samuk/OpenDualMotorDriver/Hardware/PCB-Renders/1_TopLayer.PNG

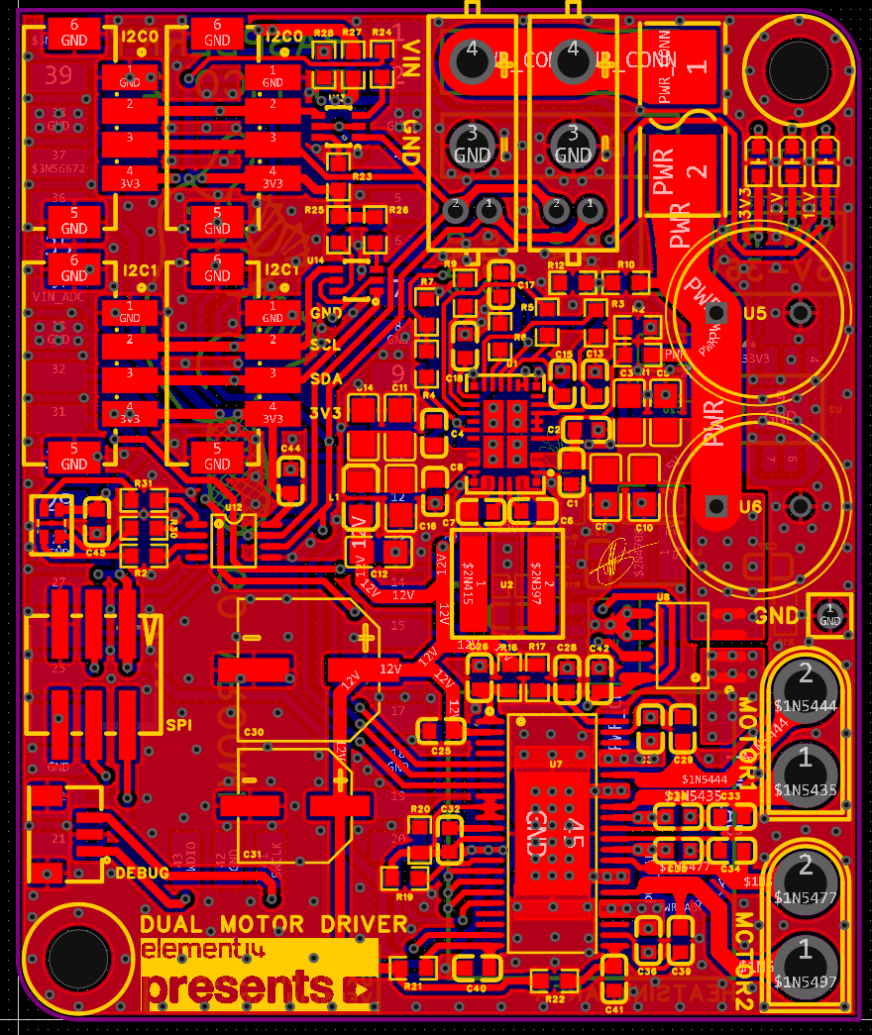
Hardware/PCB-Renders/1_TopLayer.PNG
