samuk/OpenDualMotorDriver/Hardware/PCB-Renders/2_GNDLayer1.PNG

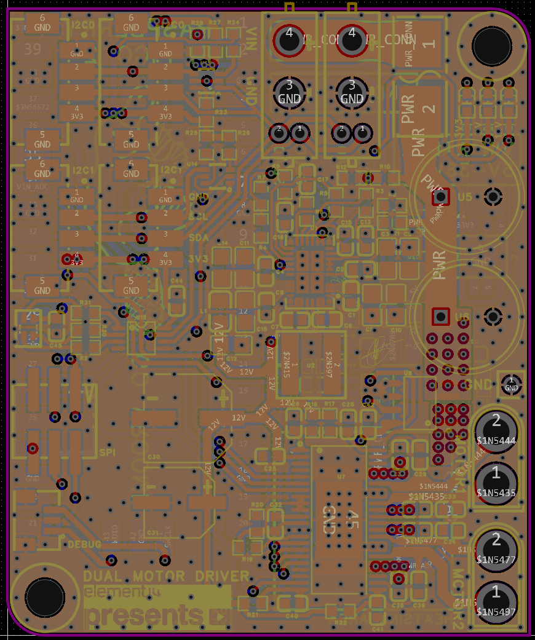
Hardware/PCB-Renders/2_GNDLayer1.PNG
