samuk/OpenDualMotorDriver/Hardware/PCB-Renders/3_GNDLayer2.PNG

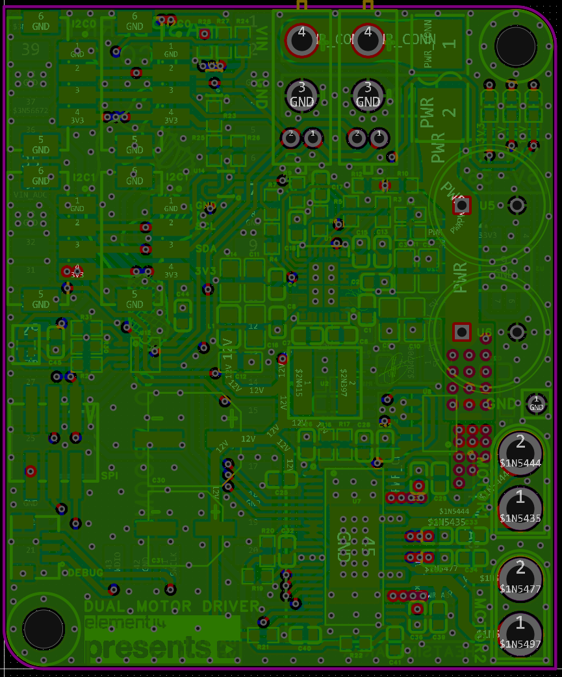
Hardware/PCB-Renders/3_GNDLayer2.PNG
