samuk/OpenDualMotorDriver/Hardware/PCB-Renders/4_BottomLayer.PNG

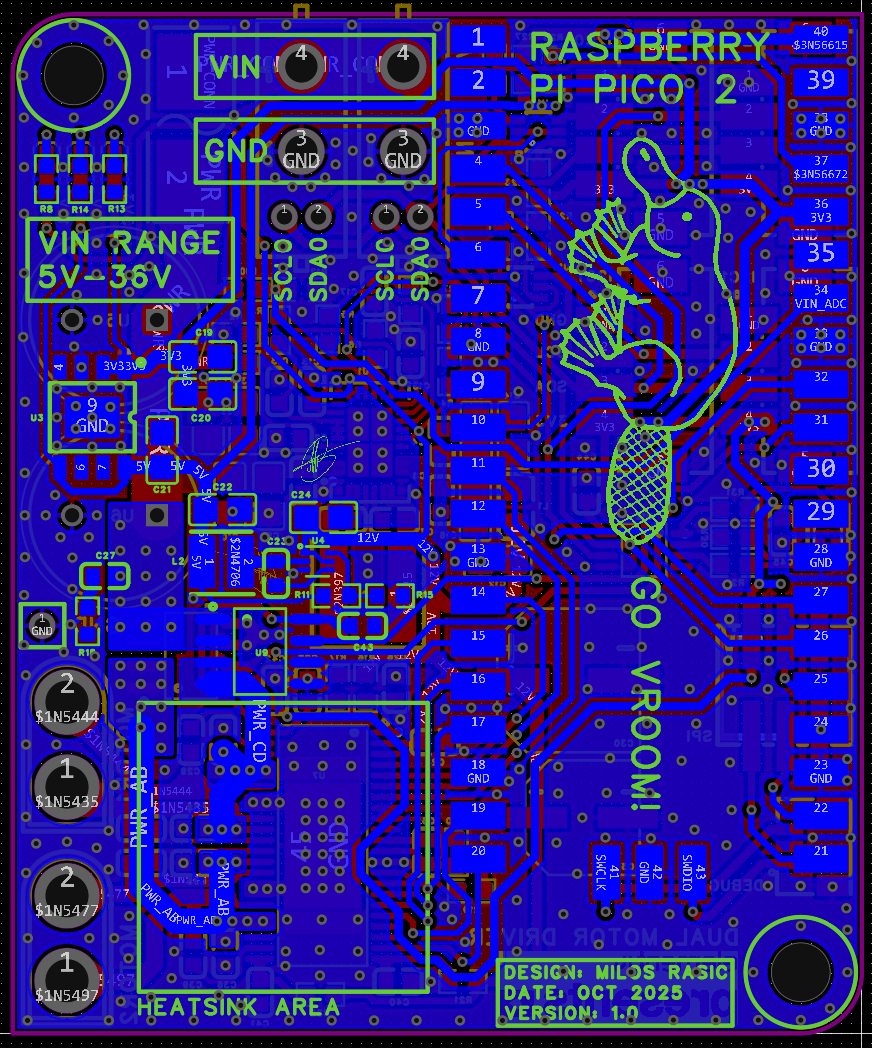
Hardware/PCB-Renders/4_BottomLayer.PNG
