samuk/OpenDualMotorDriver/Hardware/PCB-Renders/PCB_3D_2.PNG

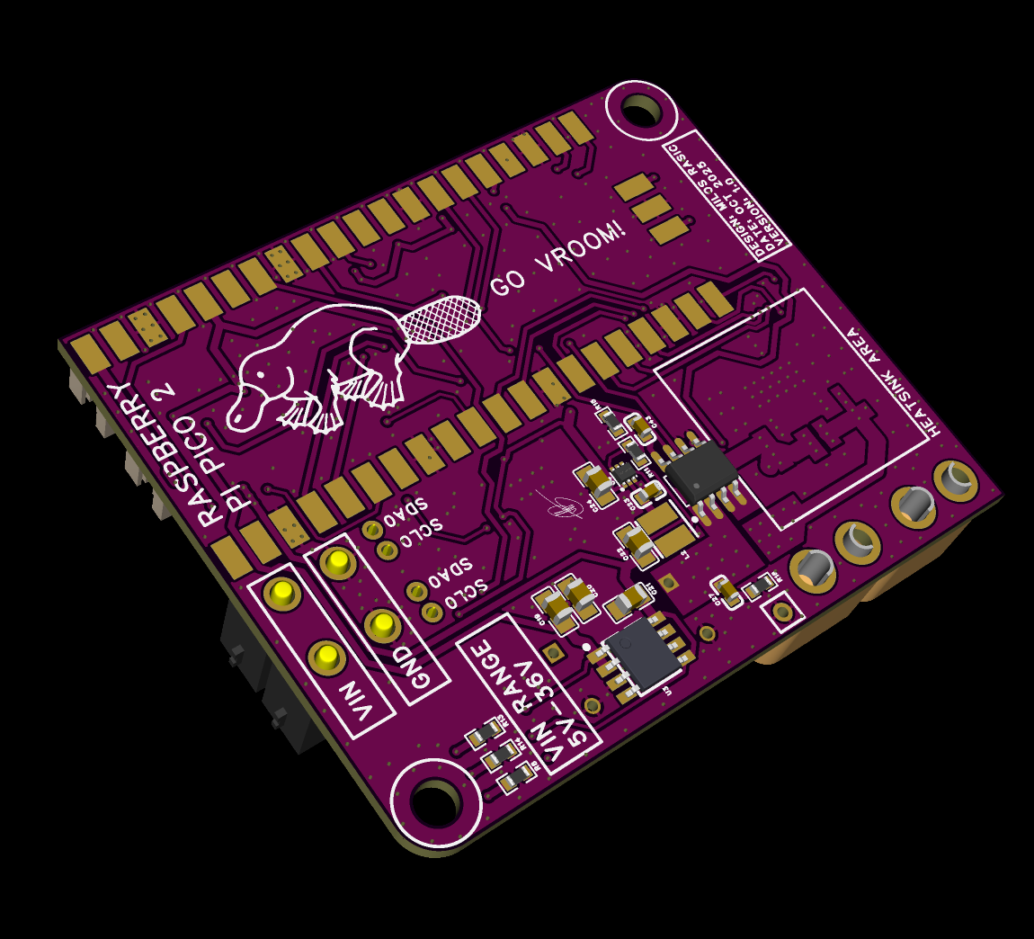
Hardware/PCB-Renders/PCB_3D_2.PNG
