samuk/OpenDualMotorDriver/Hardware/PCB-Renders/PCB_bottom.PNG

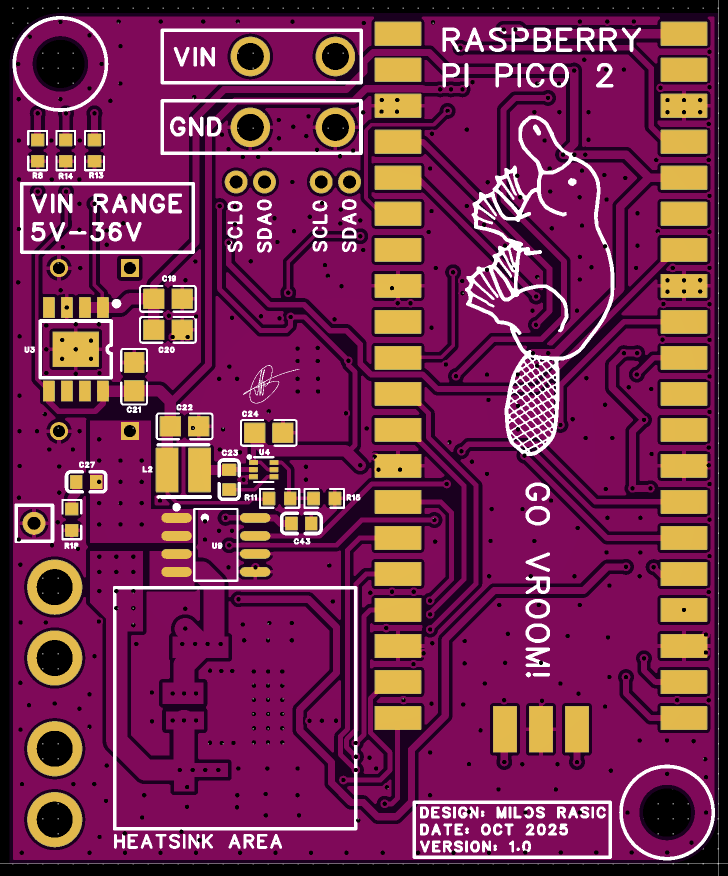
Hardware/PCB-Renders/PCB_bottom.PNG
