samuk/OpenDualMotorDriver/Hardware/PCB-Renders/PCB_top.PNG

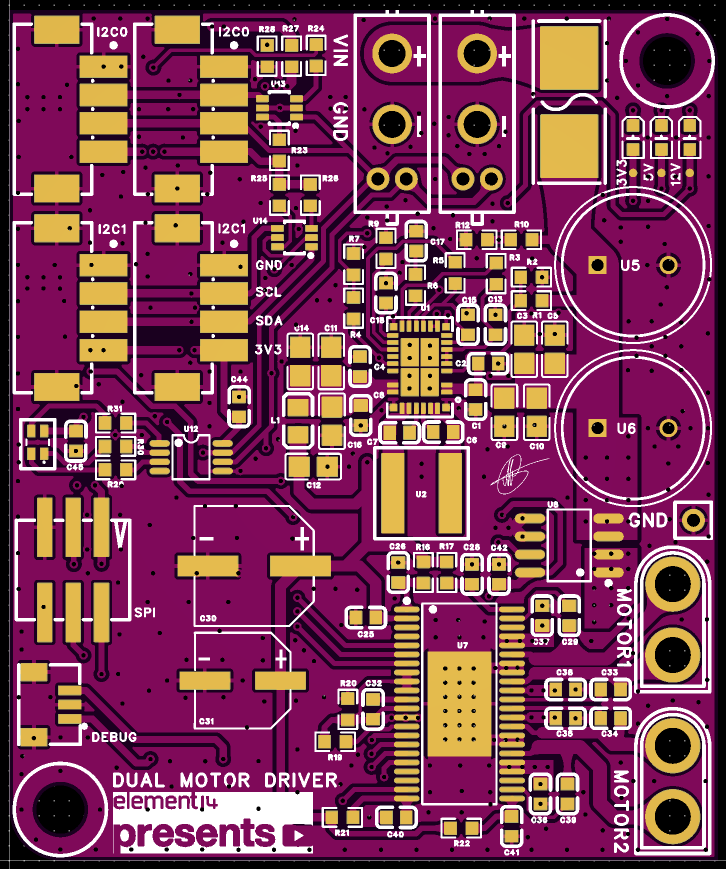
Hardware/PCB-Renders/PCB_top.PNG
