samuk/OpenDualMotorDriver/Images/DC696179-ED7C-47A8-8705-45DACD4E3CAB.JPG

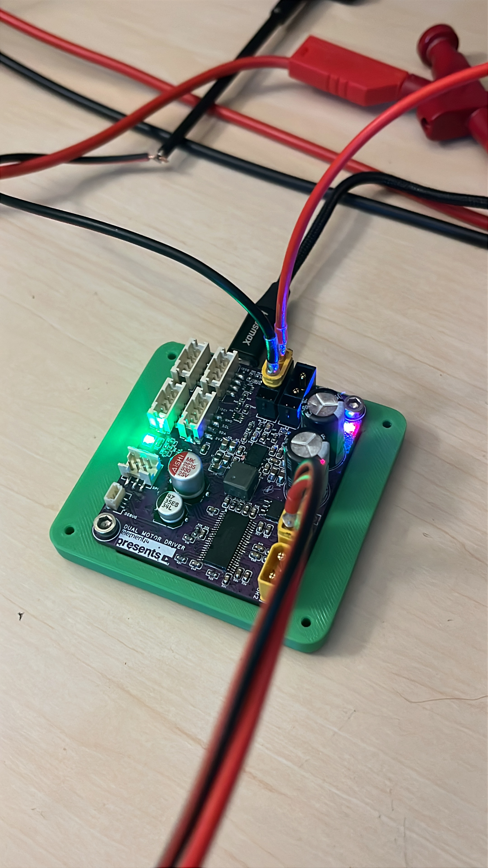
Images/DC696179-ED7C-47A8-8705-45DACD4E3CAB.JPG
