samuk/OpenDualMotorDriver/Images/Drawing3_PID.PNG

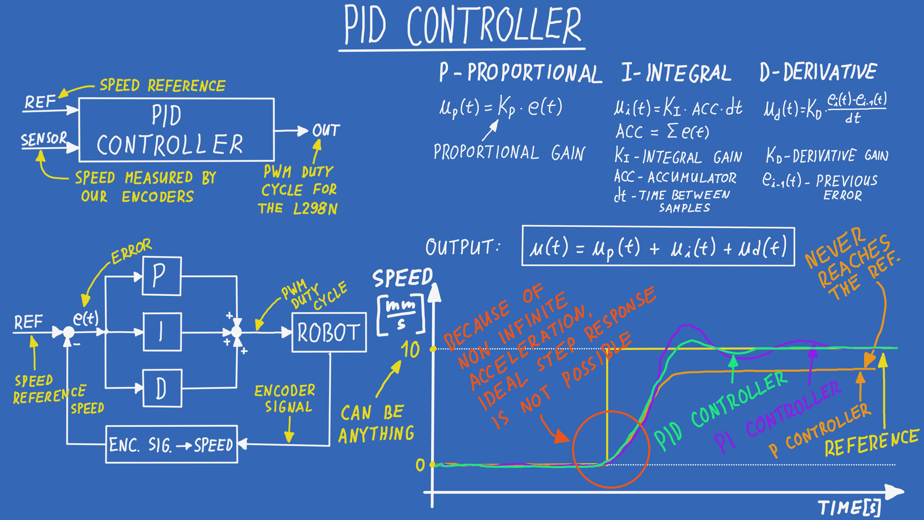
Images/Drawing3_PID.PNG
