samuk/OpenDualMotorDriver/Images/Drawing 1.PNG

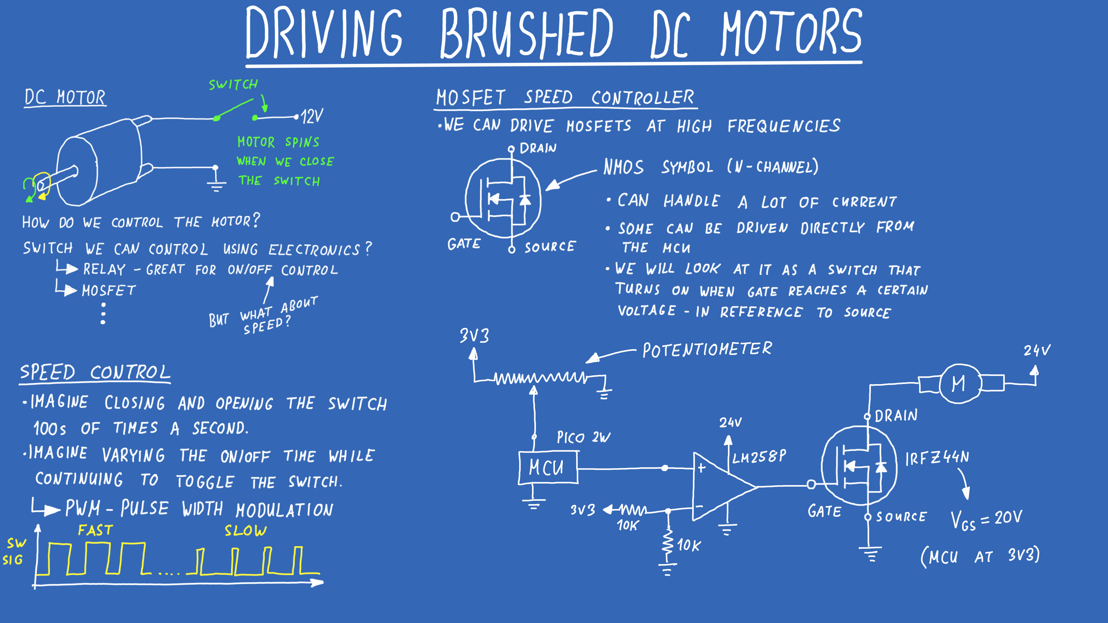
Images/Drawing 1.PNG
