samuk/OpenDualMotorDriver/Images/Drawing 2.PNG

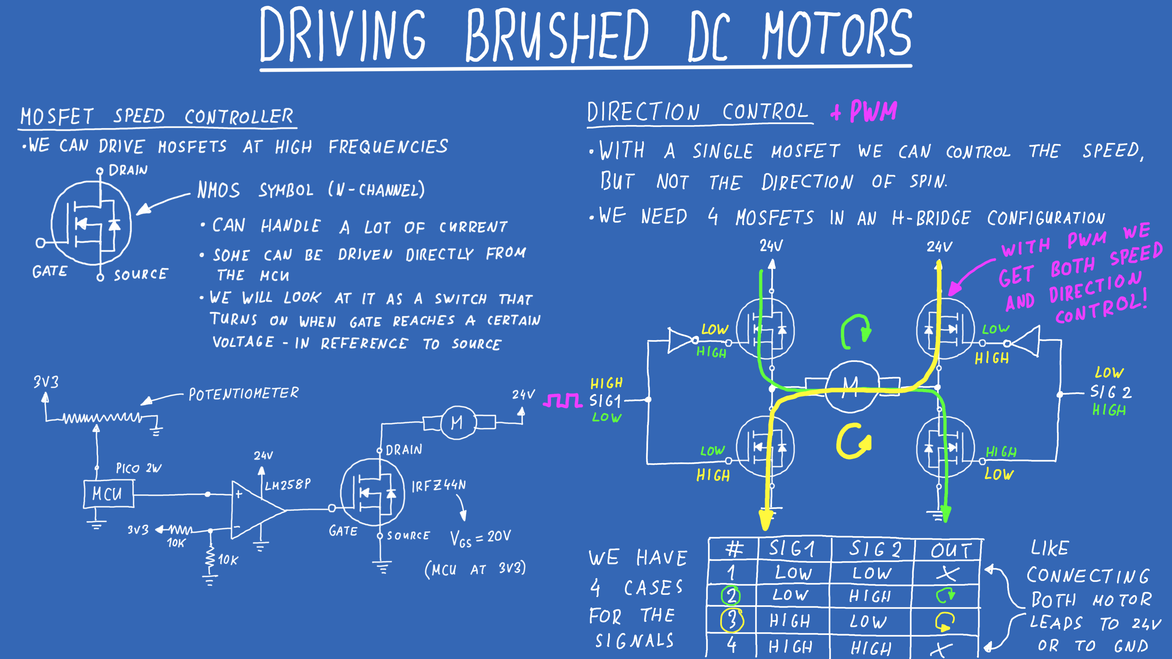
Images/Drawing 2.PNG
