samuk/OpenDualMotorDriver/Images/IMG_2347.JPG

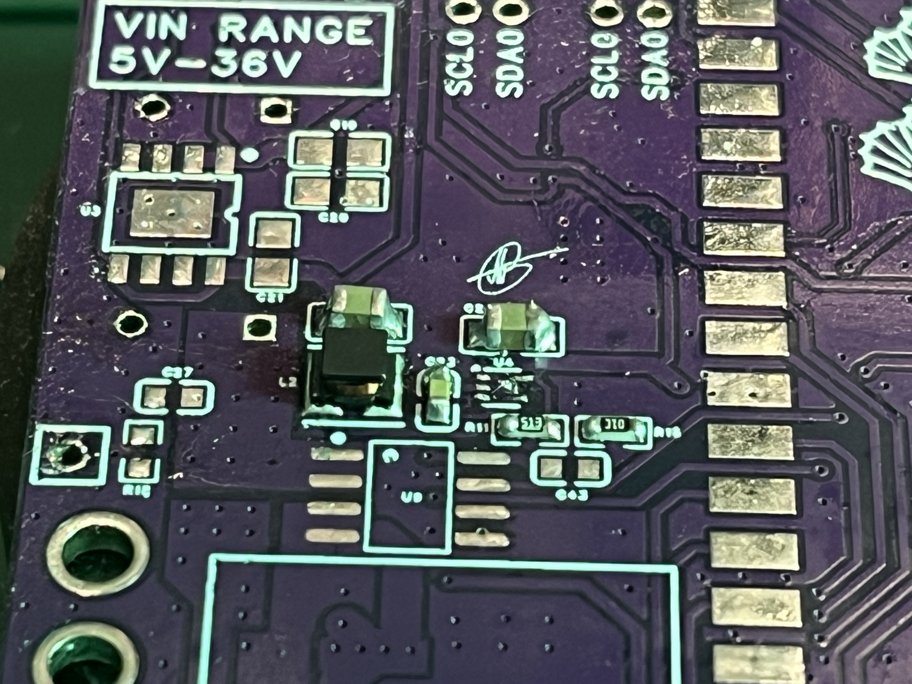
Images/IMG_2347.JPG
