samuk/OpenDualMotorDriver/Images/IMG_2360.JPG

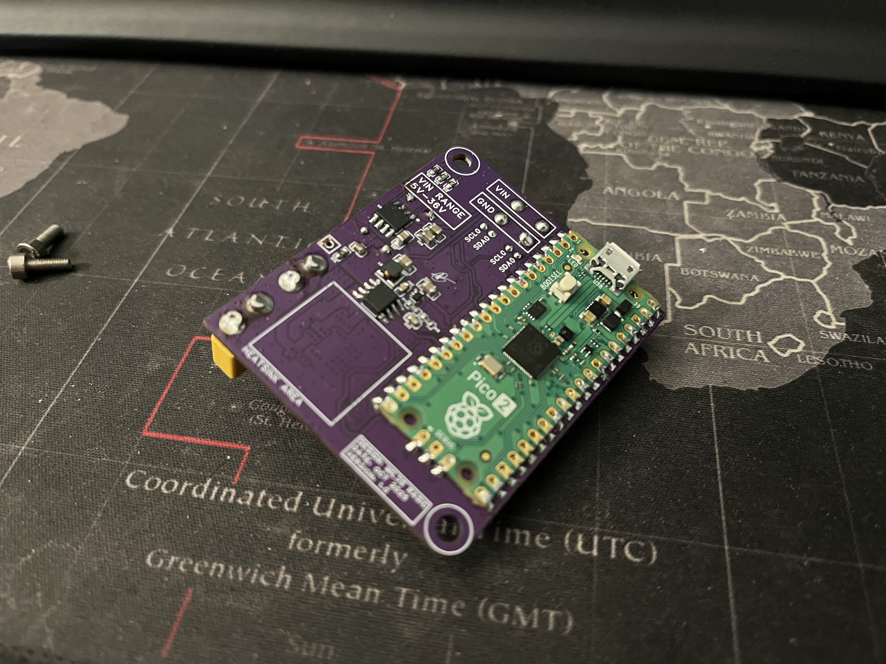
Images/IMG_2360.JPG
