samuk/OpenDualMotorDriver/Images/IMG_2361.JPG

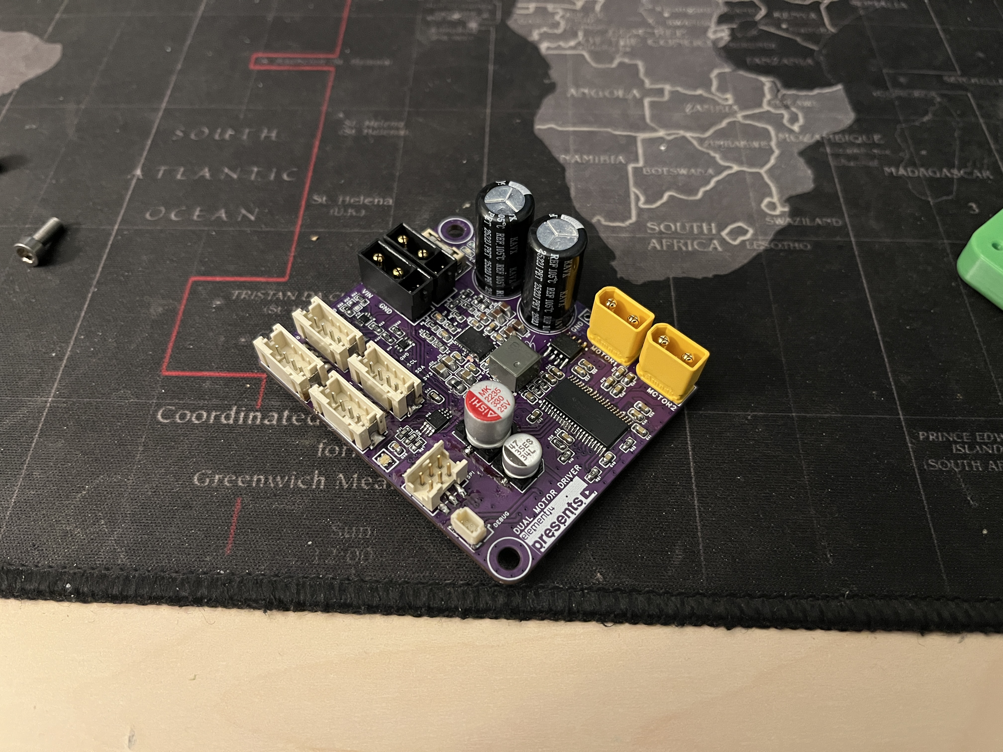
Images/IMG_2361.JPG
