samuk/OpenDualMotorDriver/Images/IMG_2495.JPG

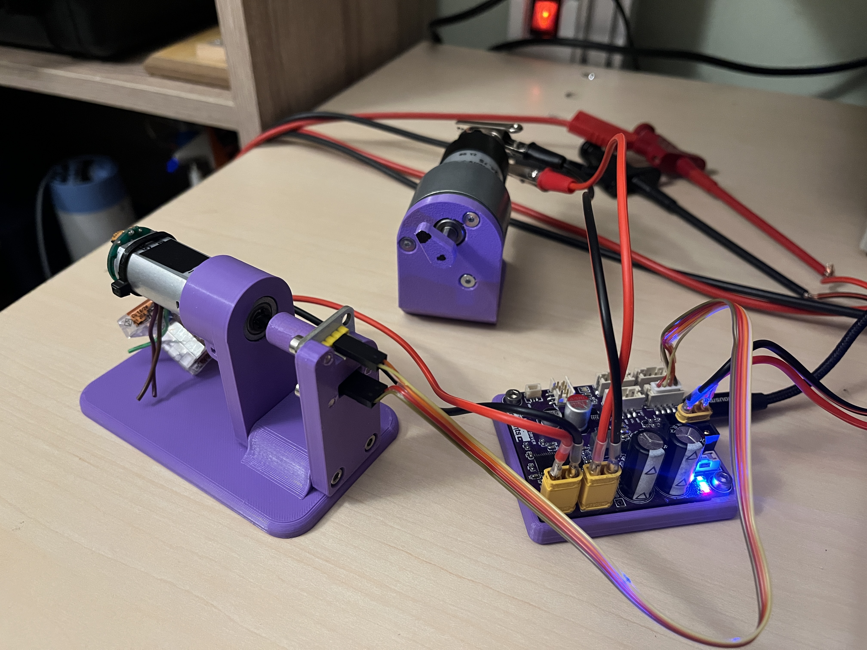
Images/IMG_2495.JPG
