samuk/OpenDualMotorDriver/Images/IMG_2496.JPG

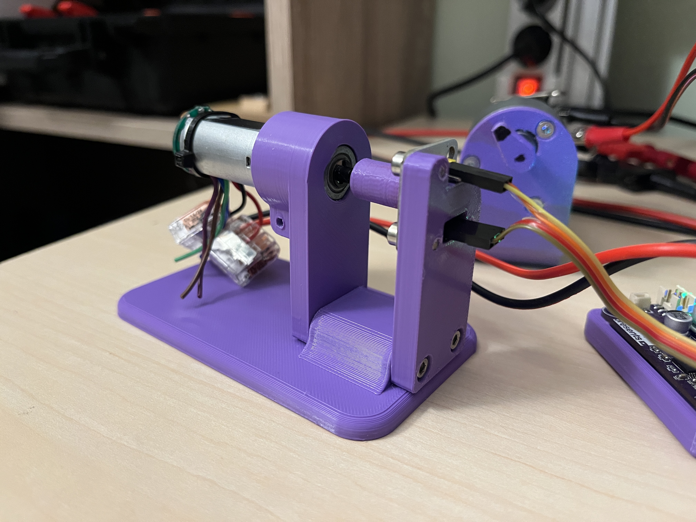
Images/IMG_2496.JPG
