samuk/OpenDualMotorDriver/Images/IMG_2497.JPG

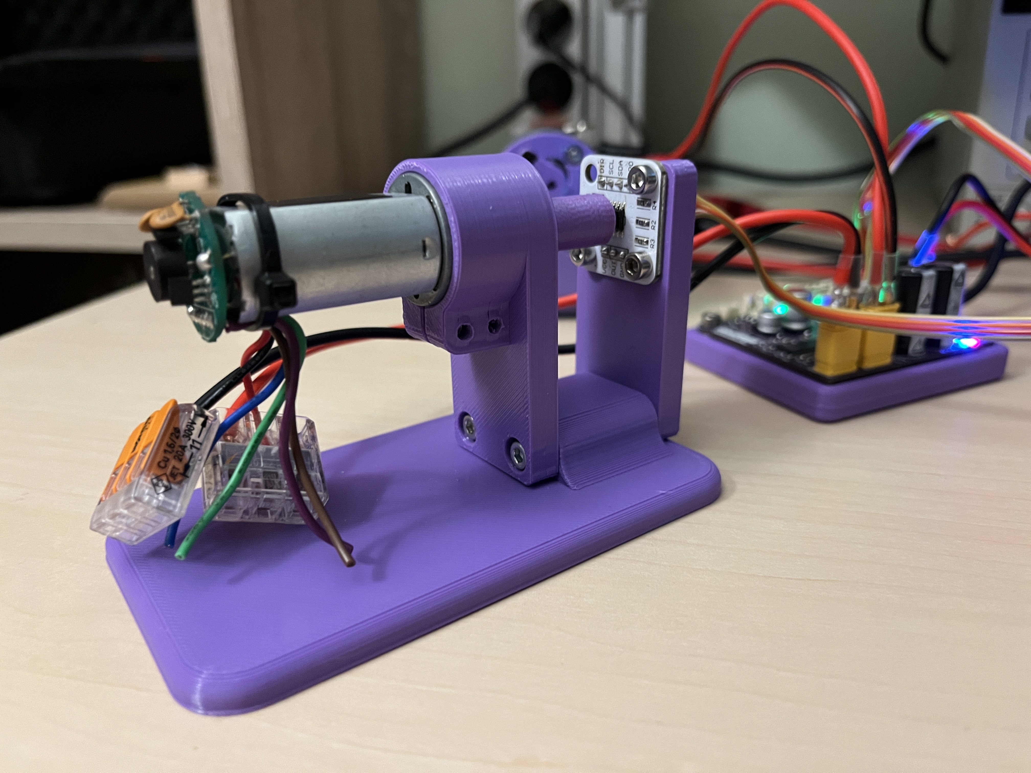
Images/IMG_2497.JPG
