samuk/OpenDualMotorDriver/Images/IMG_2498.JPG

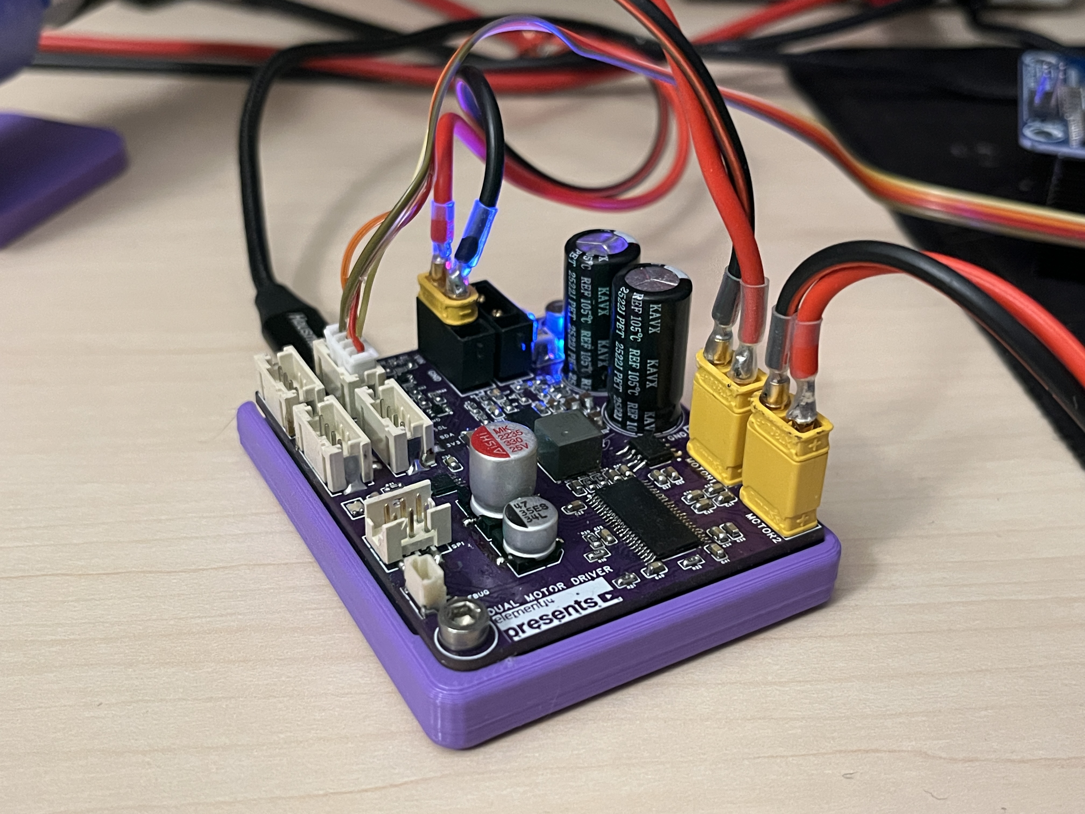
Images/IMG_2498.JPG
