samuk/OpenDualMotorDriver/Images/IMG_2499.JPG

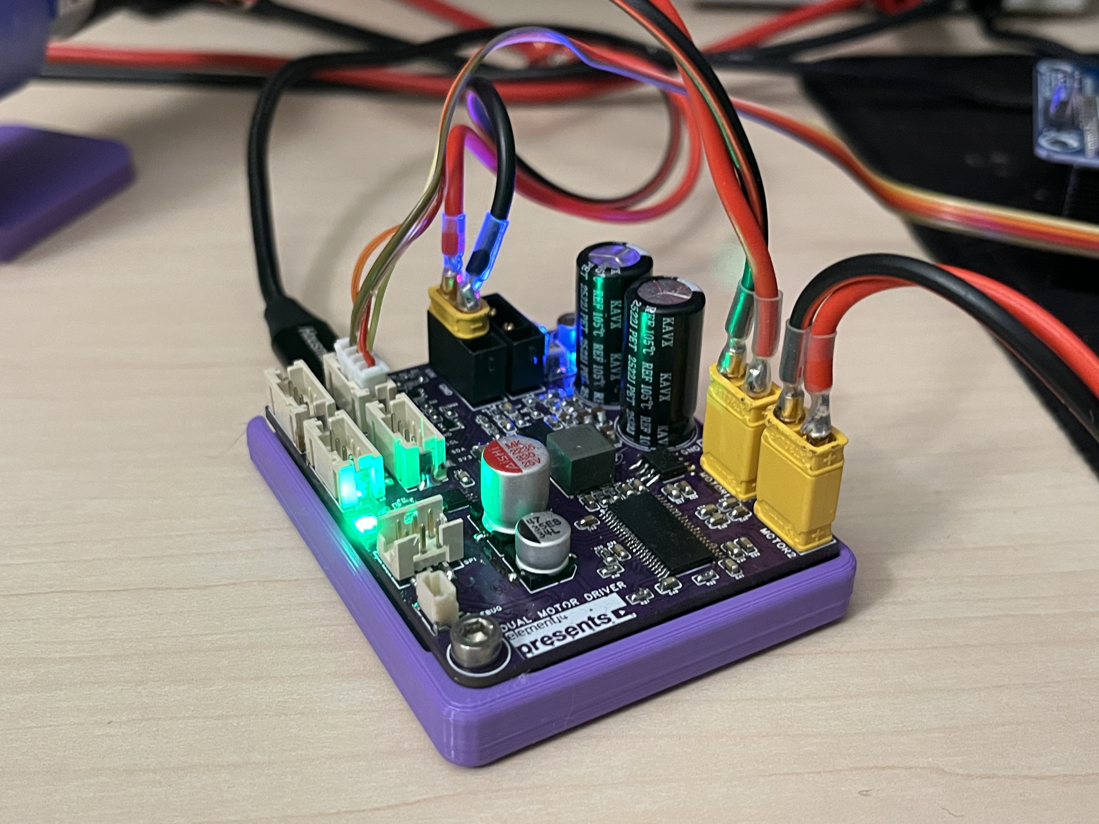
Images/IMG_2499.JPG
