samuk/OpenDualMotorDriver/Images/IMG_2500.JPG

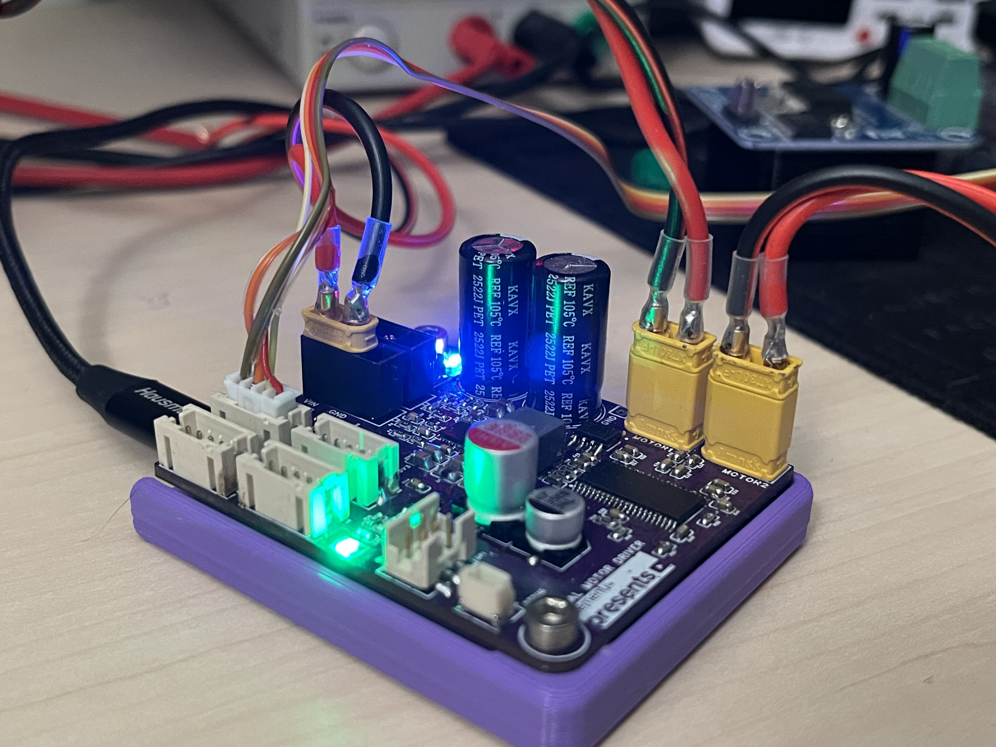
Images/IMG_2500.JPG
