samuk/OpenDualMotorDriver/Images/IMG_2501.JPG

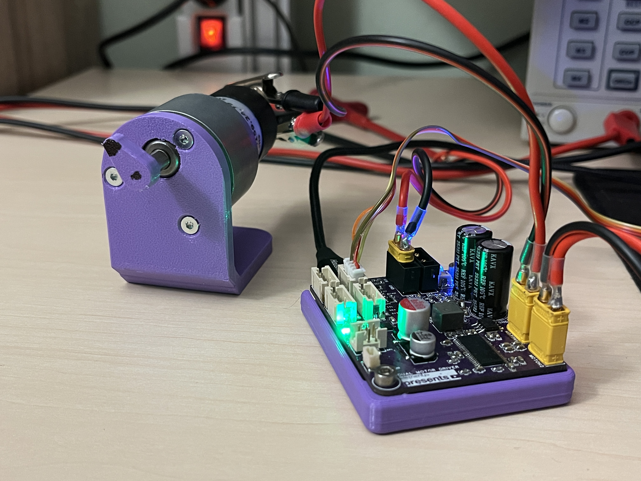
Images/IMG_2501.JPG
