samuk/OpenDualMotorDriver/Images/IMG_2502.JPG

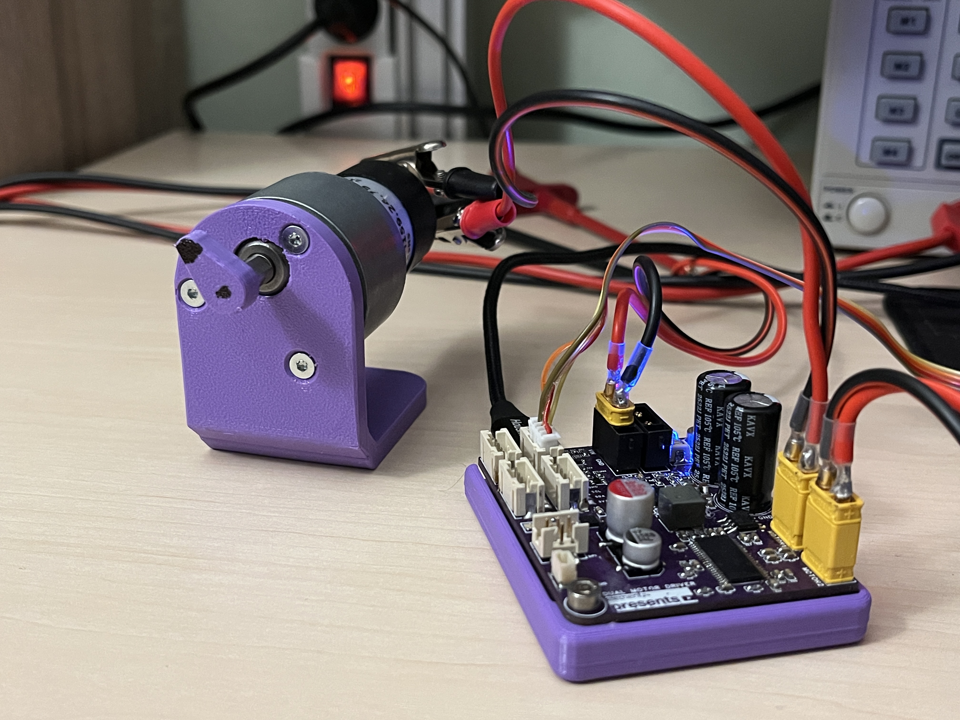
Images/IMG_2502.JPG
