samuk/OpenDualMotorDriver/Images/IMG_2504.JPG

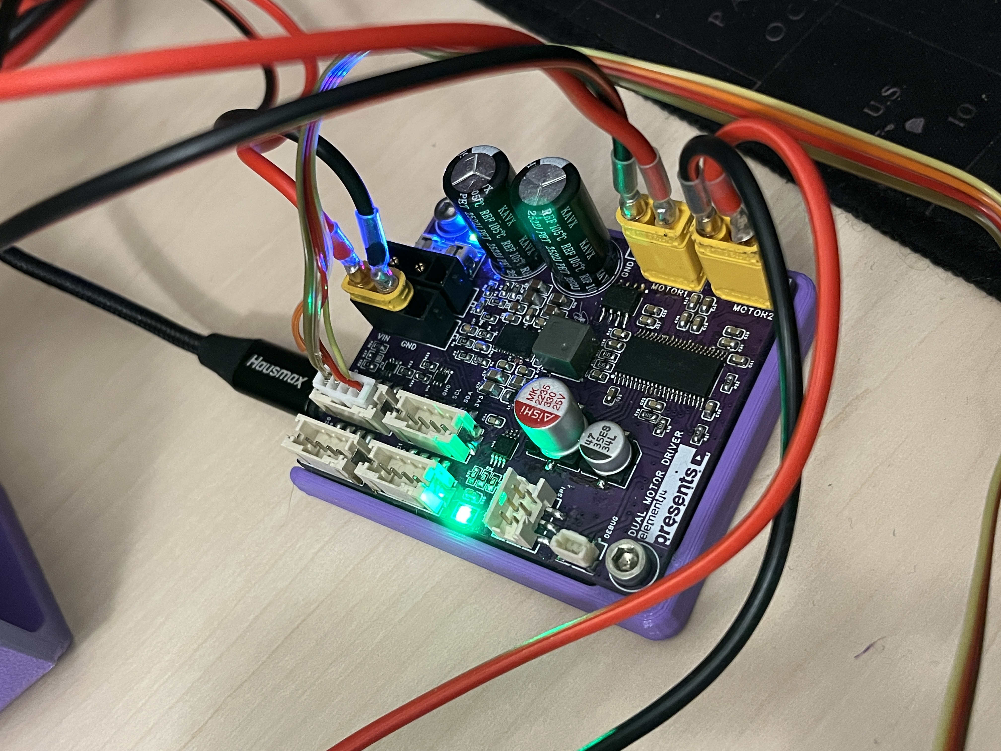
Images/IMG_2504.JPG
