samuk/OpenDualMotorDriver/Images/IMG_2505.JPG

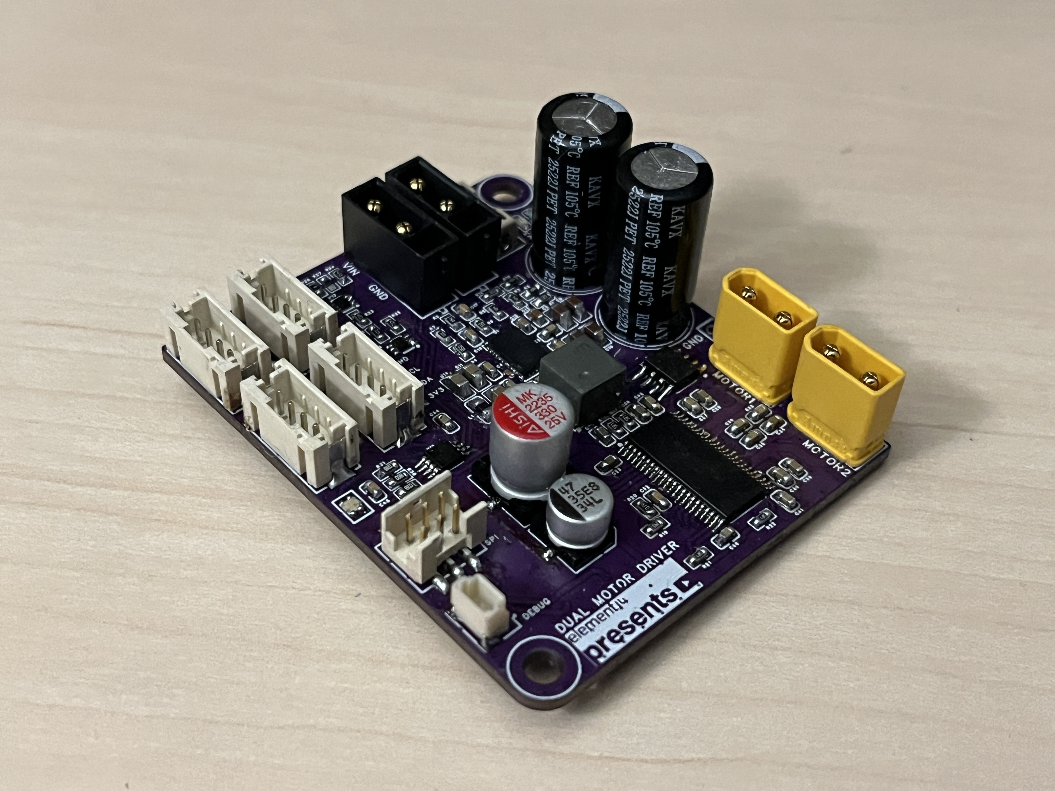
Images/IMG_2505.JPG
