samuk/OpenDualMotorDriver/Images/IMG_2508.jpg

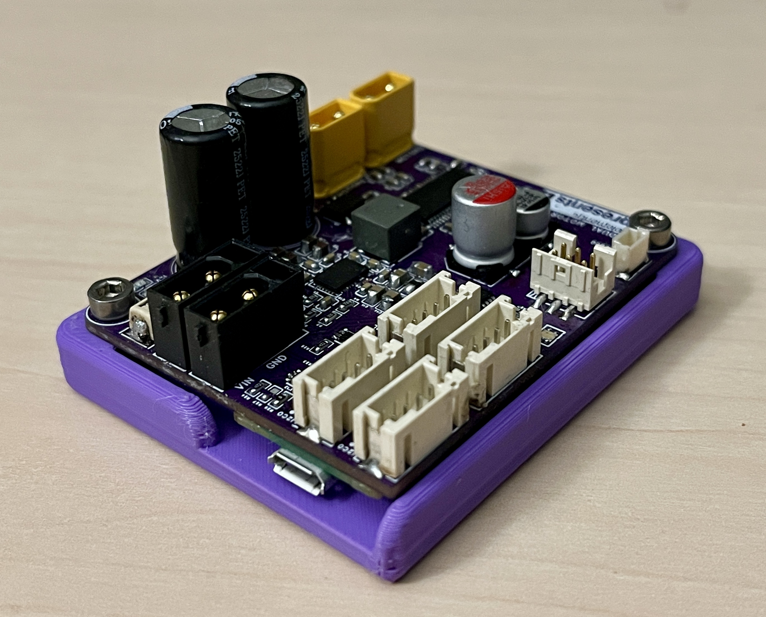
Images/IMG_2508.jpg
