samuk/OpenDualMotorDriver/Images/IMG_2509.jpg

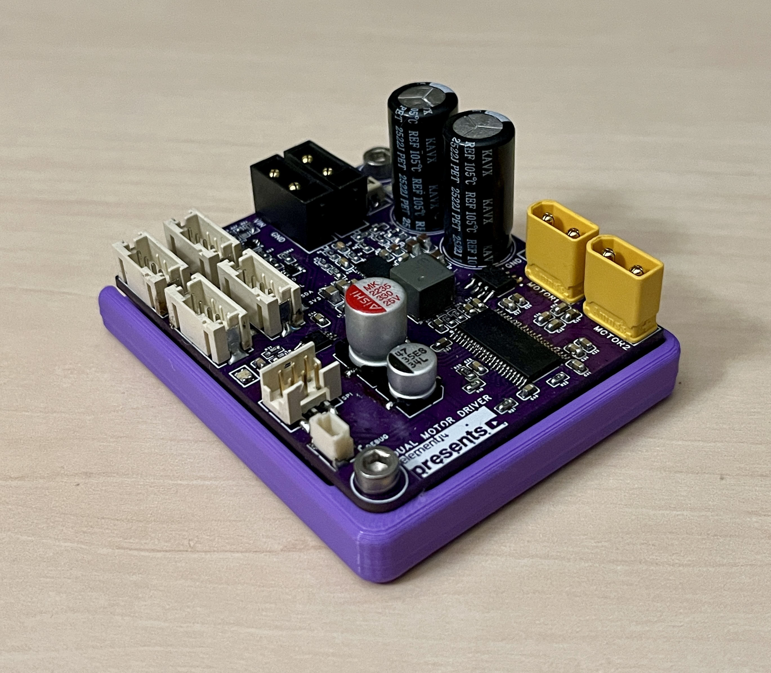
Images/IMG_2509.jpg
