samuk/OpenDualMotorDriver/Hardware/Schematics/SCH_Schematic1_2026-05-02.pdf

# BUCK BOOST CONVERTER 5-36V IN 12V 3A OUT

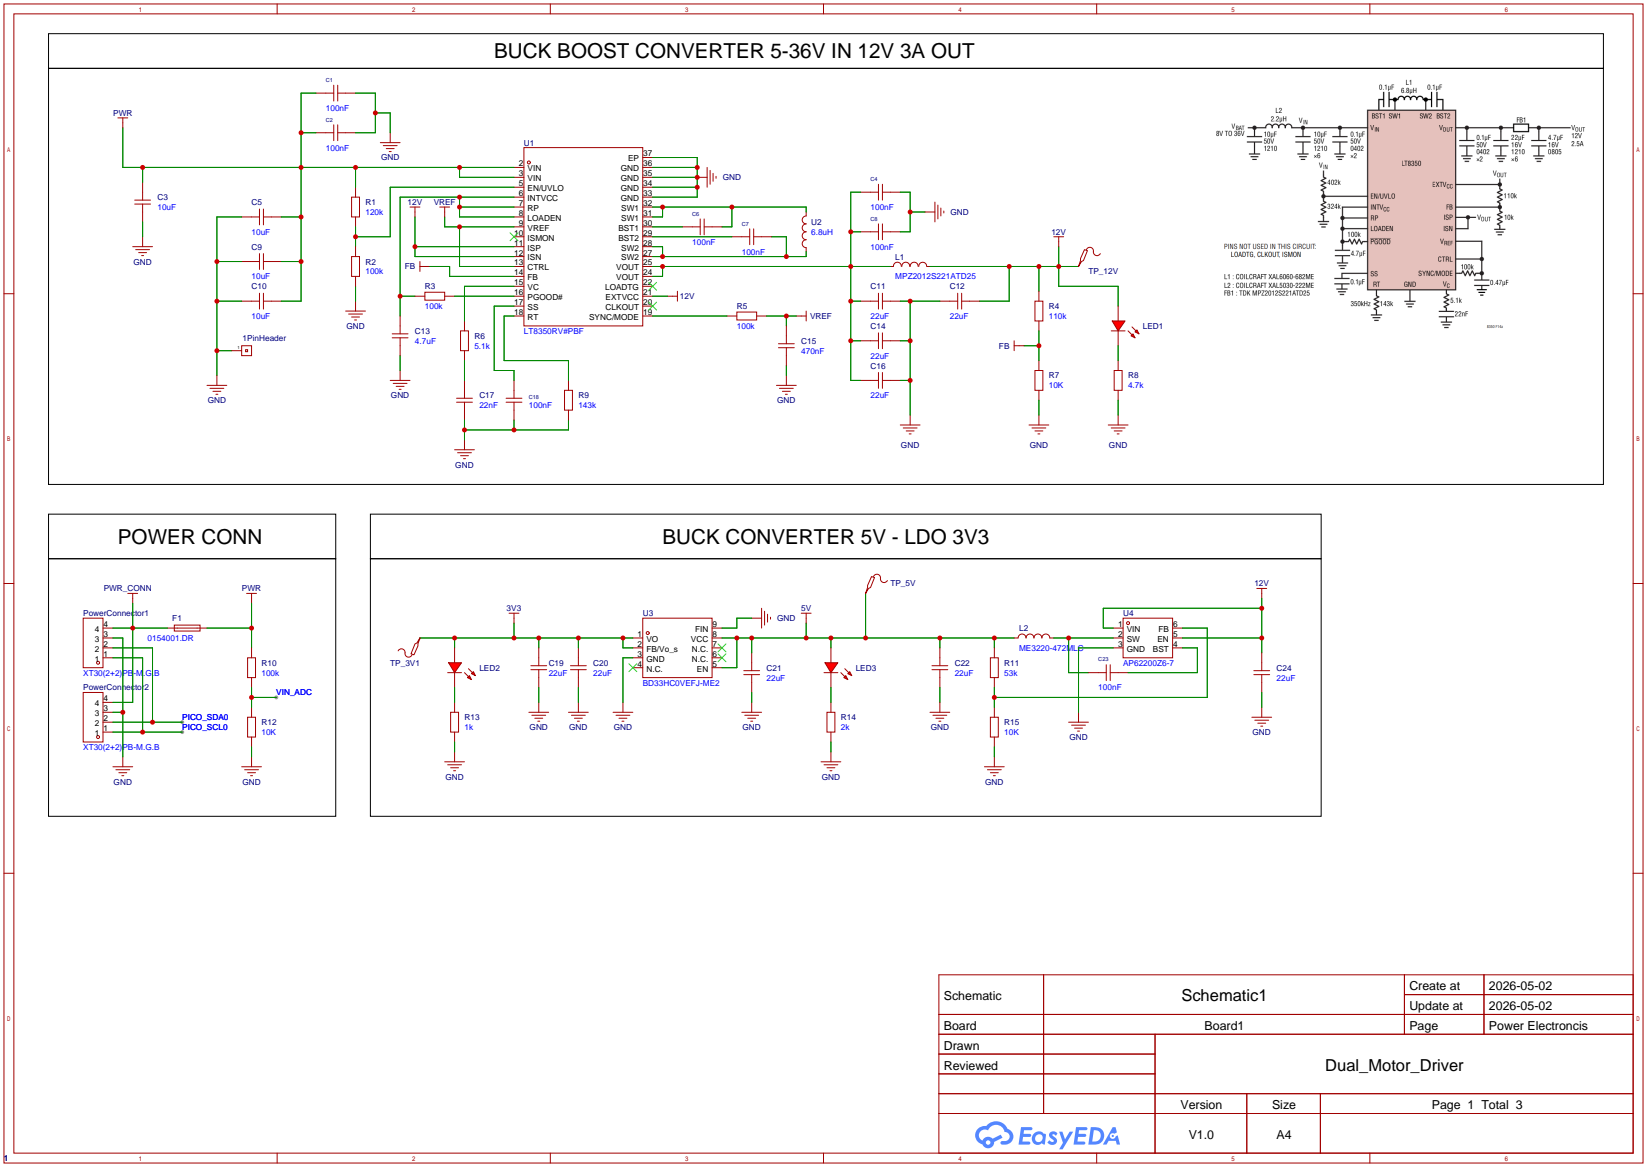
[picture p36: page 1]

Schematic | Schematic1 | Create at | 2026-05-02

Update at | 2026-05-02

Board | Board1 | Page | Power Electroncis
Drawn | | Dual_Motor_Driver
Reviewed

Version | Size | Page 1 Total 3
V1.0 | A4

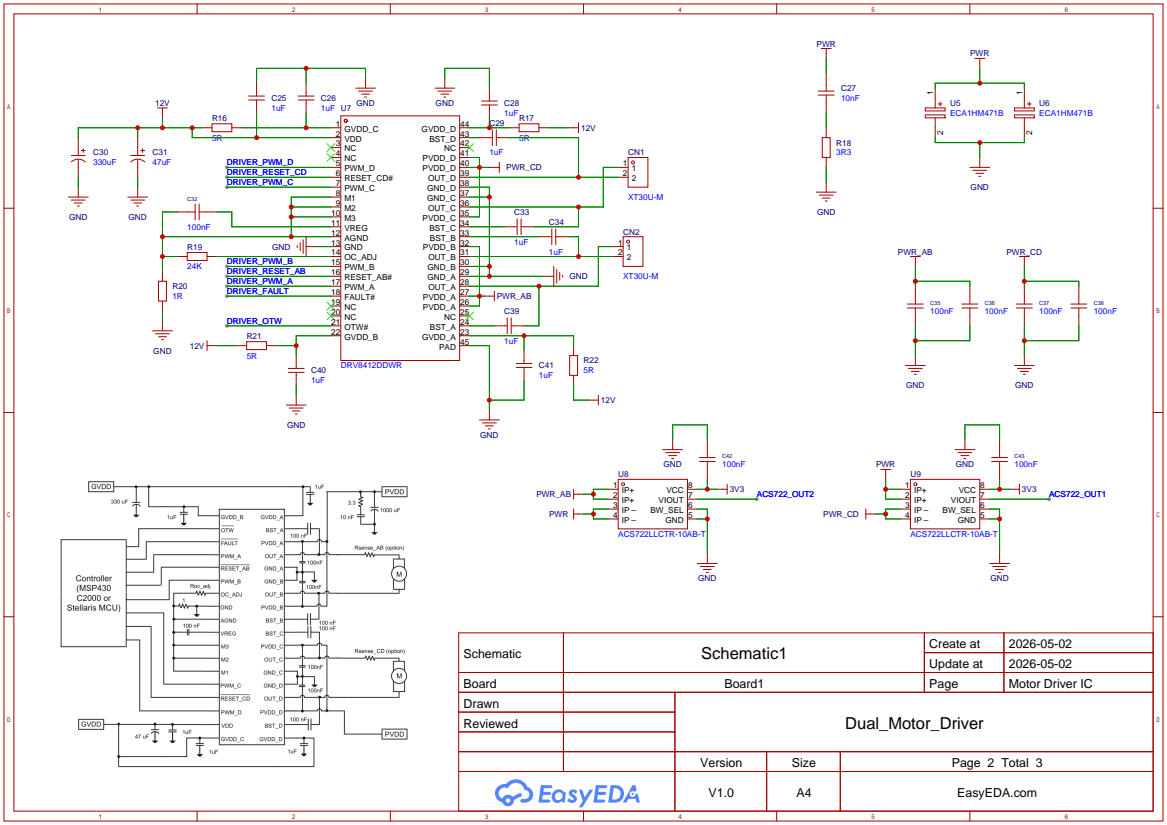
[picture p37: page 2]

Schematic | Schematic1 | Create at | 2026-05-02

Update at | 2026-05-02

Board | Board1 | Page | Motor Driver IC
Drawn | | Dual_Motor_Driver
Reviewed

Version | Size | Page 2 Total 3
V1.0 | A4 | EasyEDA.com

# I2C Connectors and Pull Up Circuit

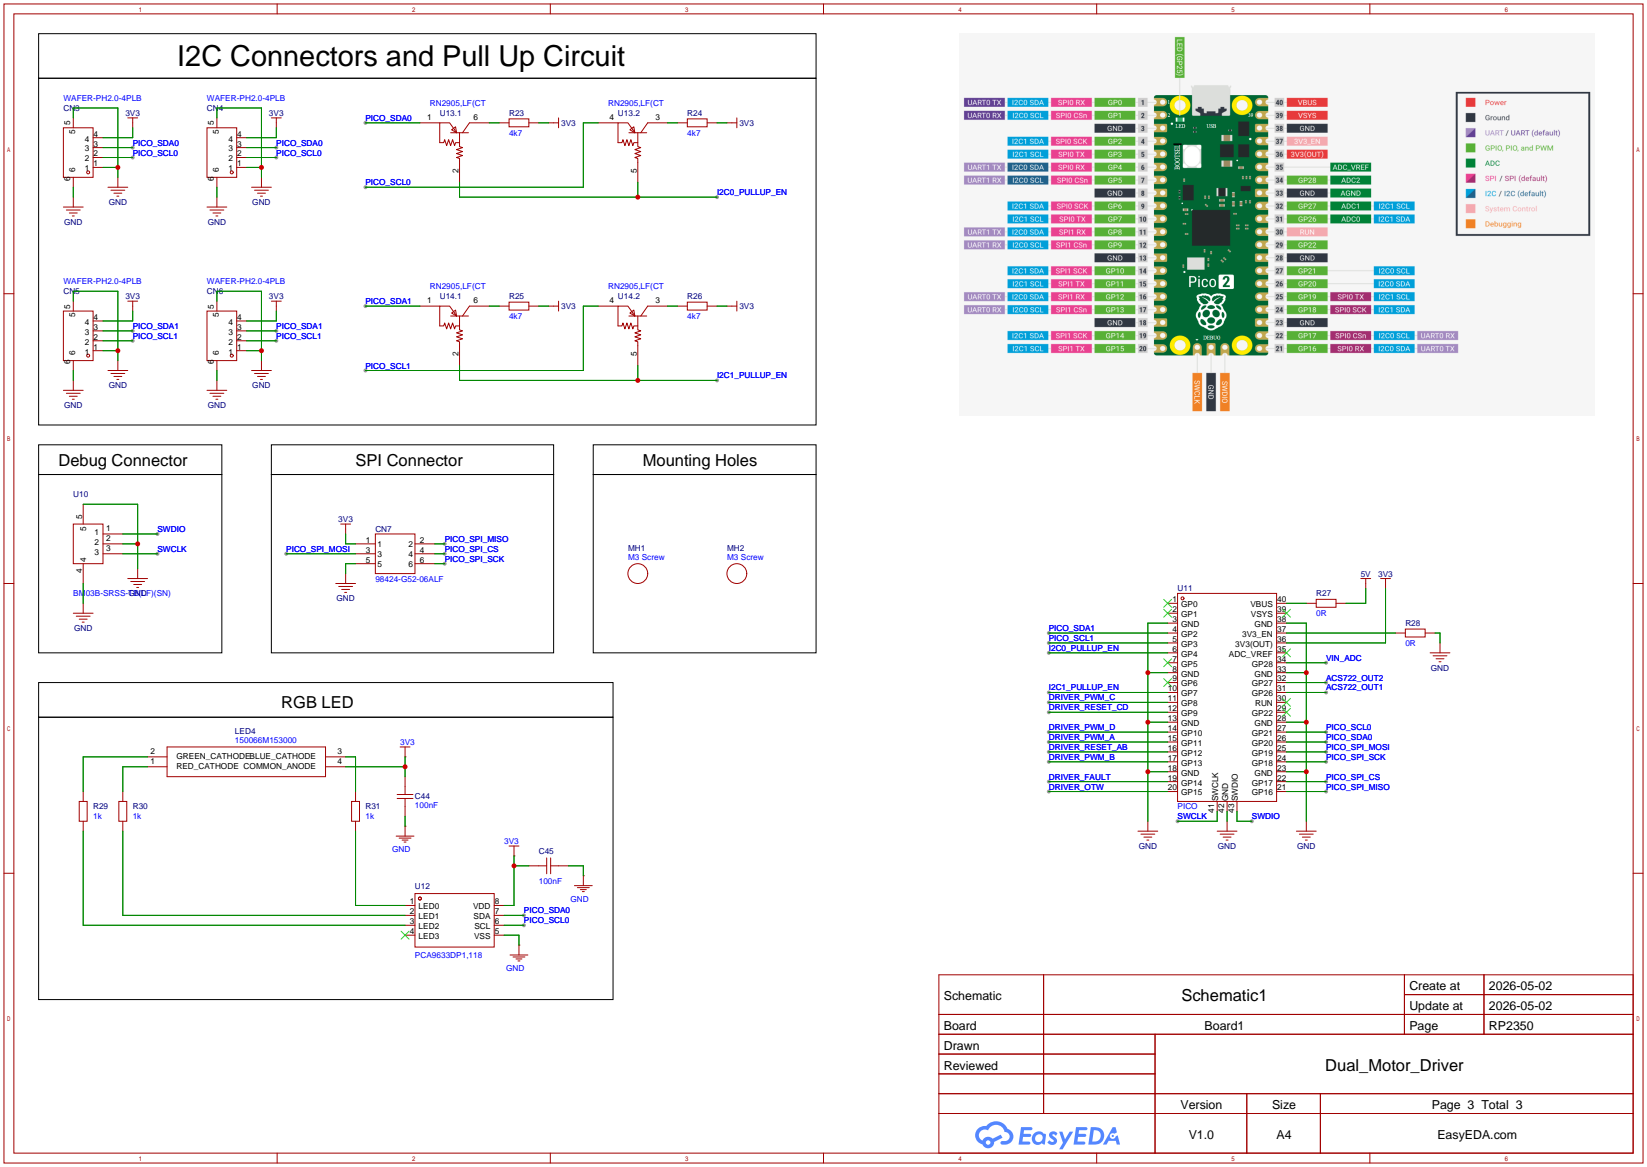
[picture p38: page 3]

BM03B-SRSS-TB(LF)(SN)

Schematic | Schematic1 | Create at | 2026-05-02

Update at | 2026-05-02

Board | Board1 | Page | RP2350
Drawn | | Dual_Motor_Driver
Reviewed

Version | Size | Page 3 Total 3
V1.0 | A4 | EasyEDA.com
