samuk/OpenDualMotorDriver/(list of files, drawings)

Other design files:
Hardware/ProPrj_Dual_Motor_Driver_2026-05-02.epro
