samuk/OpenDualMotorDriver/(commit log)

2026-05-02 PDF schematic derived from Easyeda file
2026-05-02 CSV BOM derived from Easyeda file
    [BOM_open_dual_motor_2026-05-02.csv]
