samuk/OpenDualMotorDriver/Images/IMG_2345.JPG

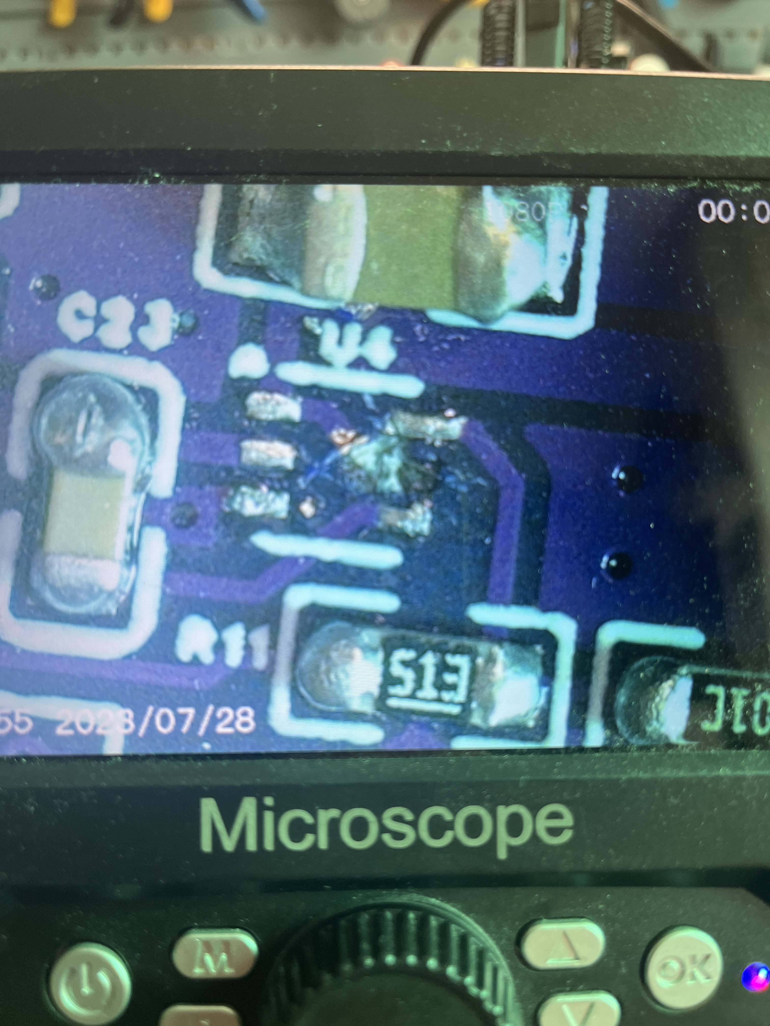
Images/IMG_2345.JPG
